aidtopia/portable_prop_power/portable_prop_power.kicad_pcb

## KiCad design Tank Panther/circuits/Circuits Du Char/Circuits Du Char.kicad_sch

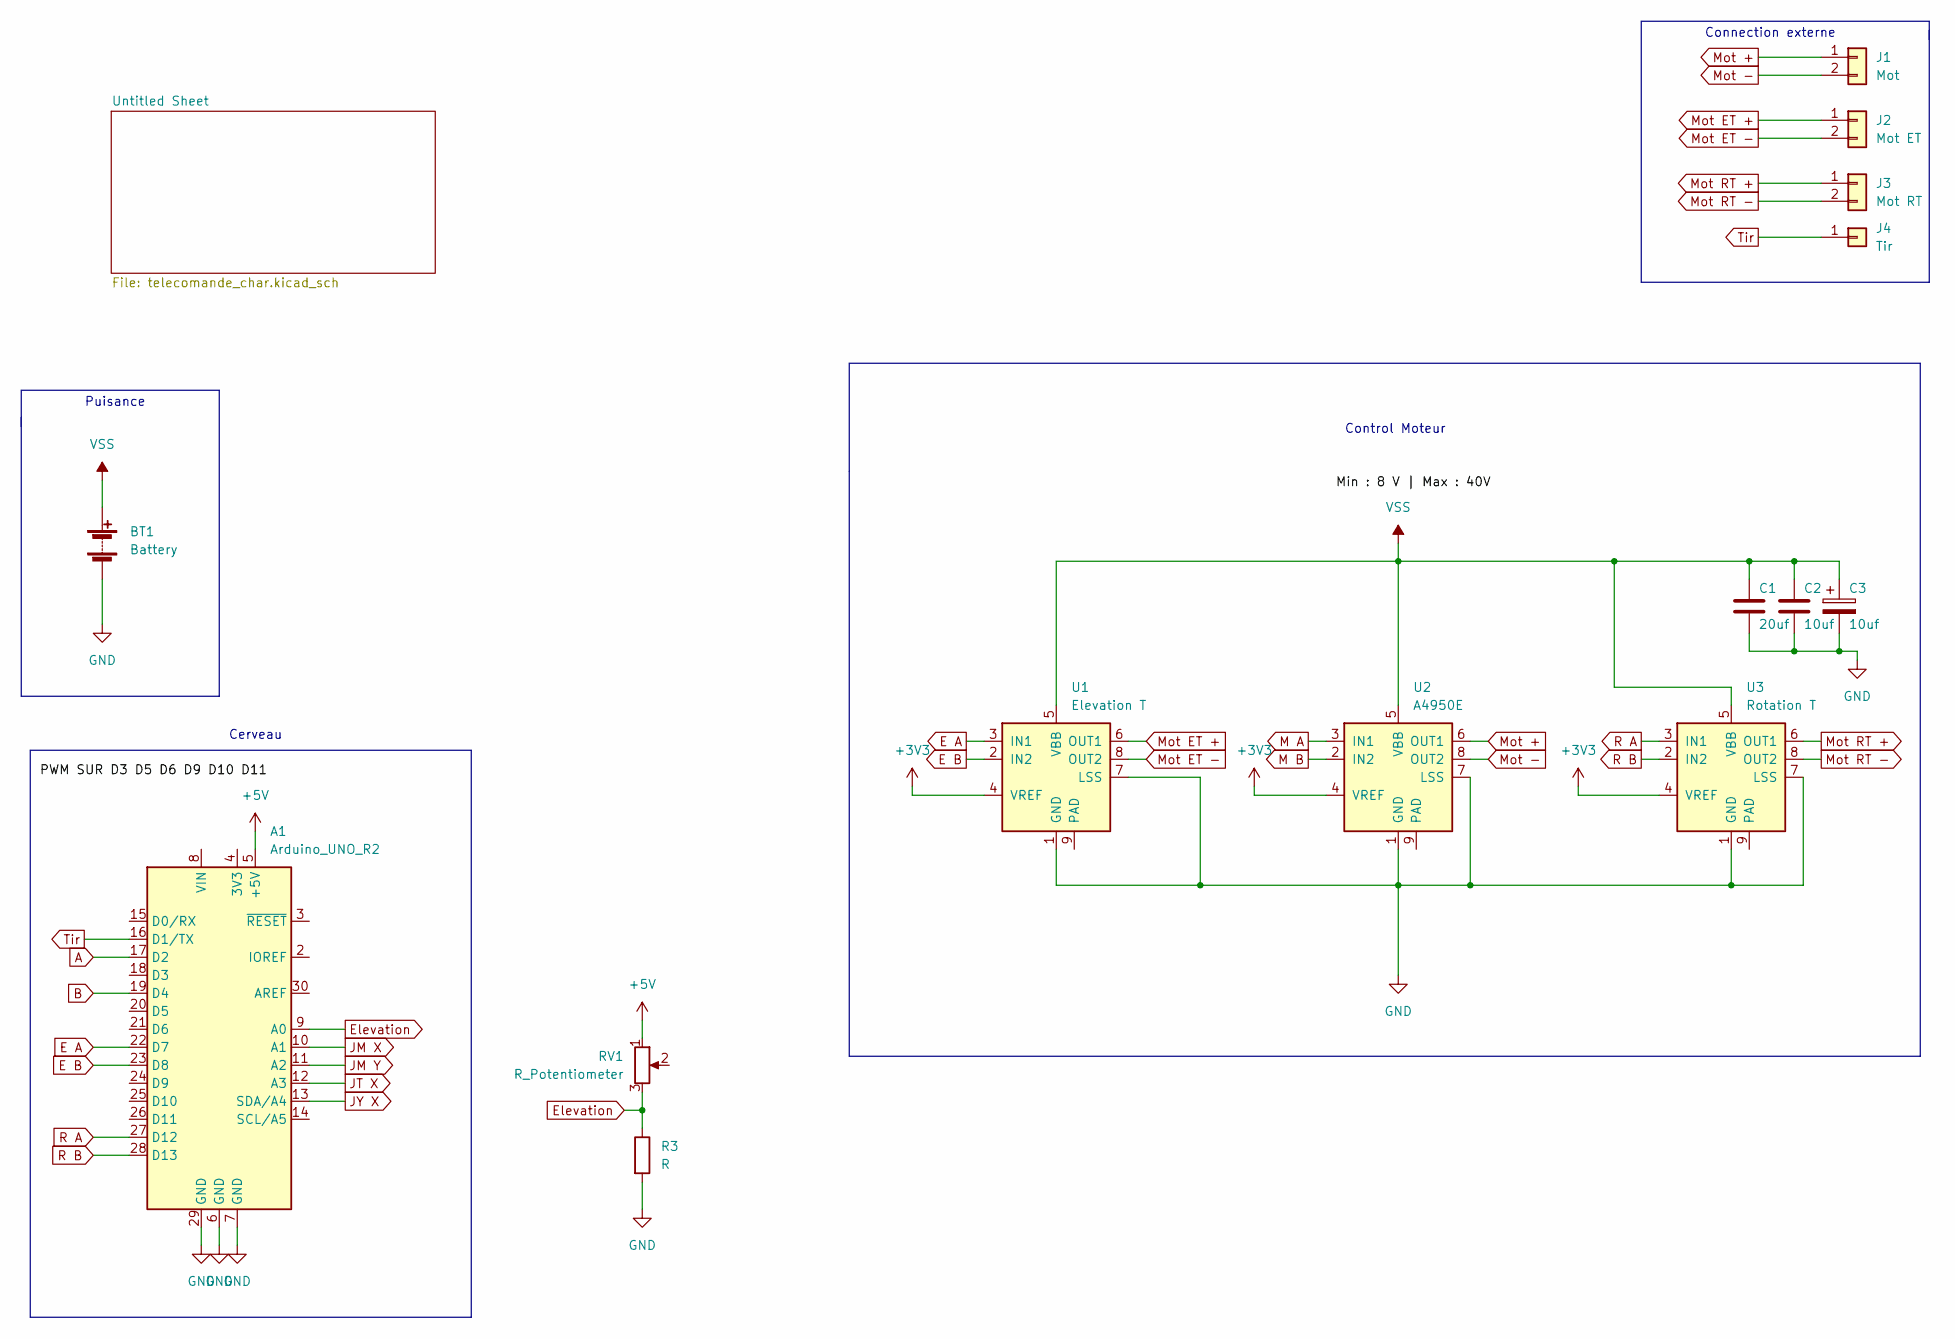
[picture p1: schematic Circuits Du Char.kicad_sch]

Parts:
A1: Arduino_UNO_R2; Arduino_UNO_R2_WithMountingHoles
BT1: Battery
C1: 20uf
C2, C3: 10uf
J1: Mot
J2: Mot ET
J3: Mot RT
J4: Tir
R3: R
RV1: R_Potentiometer
U1: Elevation T; SOIC-8-1EP_3.9x4.9mm_P1.27mm_EP2.41x3.3mm
U2: A4950E; SOIC-8-1EP_3.9x4.9mm_P1.27mm_EP2.41x3.3mm
U3: Rotation T; SOIC-8-1EP_3.9x4.9mm_P1.27mm_EP2.41x3.3mm

Connections:
+3V3: U1.4 (VREF), U2.4 (VREF), U3.4 (VREF)
+5V: A1.5 (+5V), RV1.1
A: A1.17 (D2)
B: A1.19 (D4)
E A: A1.22 (D7), U1.3 (IN1)
E B: A1.23 (D8), U1.2 (IN2)
Elevation: A1.9 (A0), R3.1, RV1.3
GND: A1.6 (GND), A1.7 (GND), A1.29 (GND), BT1.2 (-), C1.2, C2.2, C3.2, R3.2, U1.1 (GND), U1.7 (LSS), U2.1 (GND), U2.7 (LSS), U3.1 (GND), U3.7 (LSS)
JM X: A1.10 (A1)
JM Y: A1.11 (A2)
JT X: A1.12 (A3)
JY X: A1.13 (SDA/A4)
M A: U2.3 (IN1)
M B: U2.2 (IN2)
Mot +: J1.1, U2.6 (OUT1)
Mot -: J1.2, U2.8 (OUT2)
Mot ET +: J2.1, U1.6 (OUT1)
Mot ET -: J2.2, U1.8 (OUT2)
Mot RT +: J3.1, U3.6 (OUT1)
Mot RT -: J3.2, U3.8 (OUT2)
R A: A1.27 (D12), U3.3 (IN1)
R B: A1.28 (D13), U3.2 (IN2)
Tir: A1.16 (D1/TX), J4.1
VSS: BT1.1 (+), C1.1, C2.1, C3.1, U1.5 (VBB), U2.5 (VBB), U3.5 (VBB)

Notes on the sheet:
Cerveau
Connection externe
Control Moteur
Puisance
