aidtopia/portable_prop_power/portable_prop_power.kicad_pcb

## KiCad design Tank Panther/circuits/Circuits Du Char/untitled.kicad_sch

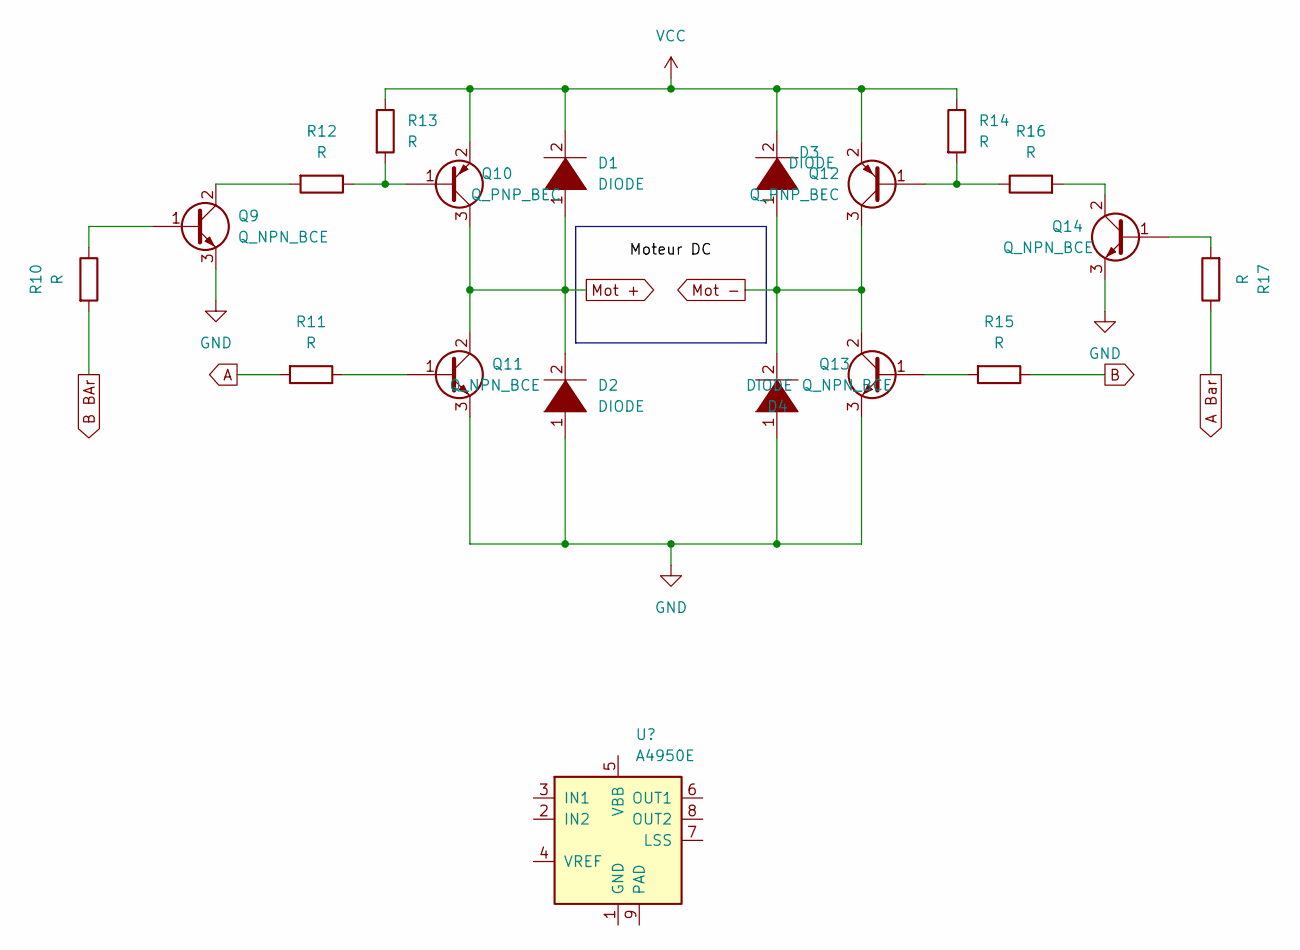
[picture p2: schematic untitled.kicad_sch]

Parts:
D1, D2, D3, D4: DIODE
Q9, Q11, Q13, Q14: Q_NPN_BCE
Q10, Q12: Q_PNP_BEC
R10, R11, R12, R13, R14, R15, R16, R17: R

Connections:
A: R11.2
A Bar: R17.1
B: R15.1
B BAr: R10.2
GND: D2.1 (K), D4.1 (K), Q9.3 (E), Q11.3 (E), Q13.3 (E), Q14.3 (E)
Mot +: D1.1 (K), D2.2 (A), Q10.3 (C), Q11.2 (C)
Mot -: D3.1 (K), D4.2 (A), Q12.3 (C), Q13.2 (C)
unnamed: Q9.1 (B), R10.1
unnamed: Q9.2 (C), R12.2
unnamed: Q10.1 (B), R12.1, R13.2
unnamed: Q11.1 (B), R11.1
unnamed: Q12.1 (B), R14.2, R16.1
unnamed: Q13.1 (B), R15.2
unnamed: Q14.1 (B), R17.2
unnamed: Q14.2 (C), R16.2
VCC: D1.2 (A), D3.2 (A), Q10.2 (E), Q12.2 (E), R13.1, R14.1
