aidtopia/portable_prop_power/(commit log)

2024-03-15 Initial wiring schematics.
    [portable_prop_power.kicad_pcb, portable_prop_power.kicad_sch]
2024-03-15 Added SCAD for the control panel.
    Not final by any means.
    [portable_prop_power_panel.scad]
2024-03-16 Added STL files to .gitignore.
2024-03-16 Iterated on the wiring diagram. Eliminated one connector.
    [portable_prop_power.kicad_sch]
2024-03-16 First attempt at defining the layout of the components in the case.
    [portable_prop_power_panel.scad]
2024-03-17 Reworked schematic again.
    * Removed the dipictions of the lever nuts.
    * Updated the symbols for the panel meters and added a note.
    * Corrected panel meter connections after reviewing seller's diagrams.
    * Adjusted layout to separate the panel-mount components from the ones
    in the box in an effort to find better ways to make all of the wiring
    connections.
    * Added a fuse.
    [portable_prop_power.kicad_sch]
2024-03-23 Continued hacking on the project box design.
    [portable_prop_power_panel.scad]
2024-03-24 Improved the project box design.
    This should be "complete enough" to make a functional power supply,
    though code could stand a bunch more refactoring, and it's all pretty
    specific about the particular modules being used.
    [portable_prop_power_panel.scad]
2024-03-25 Added labels to base plate.
    [portable_prop_power_panel.scad]
2024-03-26 Started separating the walls of the box from the base.
    [portable_prop_power_panel.scad]
2024-03-26 Renamed several variables as a refactor step.
    [portable_prop_power_panel.scad]
2024-03-26 Added explanation and modeled a hole instead of a grommet.
    [portable_prop_power_panel.scad]
2024-03-26 Refactored to eliminate a lot of duplicate parameter definitions.
    Moved the three main modules inside a module that represents the entire
    box so that key dimensions could be set in a single place.
    [portable_prop_power_panel.scad]
2024-03-26 Finally made it possible to mate the walls with the base.
    [portable_prop_power_panel.scad]
2024-03-27 Made Ridgid adapter from Anztek fit the base.
    The center pair of holes from my more recently ordered adapter plate
    are at a different offset than the ones on the Ecarke brand one I
    already had. The base now has pilot holes for both, so you can mount
    either. The unused pair of pilot holes is covered by the plate.
    [portable_prop_power_panel.scad]
2024-03-27 Tweaked the teardrop shape of the horizontal holes for the glands.
    [portable_prop_power_panel.scad]
2024-03-27 Corrected screw spacing for LM2596 (HW-411) module.
    [portable_prop_power_panel.scad]
2024-03-28 Lowered the default height for the walls in the project box.
    I wasn't really using 64 mm anyway. My current prototype is 58 mm,
    which is still a few millimeters taller than necessary.
    [portable_prop_power_panel.scad]
2024-04-02 Added wire color notations to schematic.
    I'm not sure whether that's a good color scheme, but it's something I'm
    considering to make it simpler to wire correctly.
    [portable_prop_power.kicad_sch]
2024-04-02 Adjusted some parameters for a better fit.
    * Increased pilot hole size in vertical supports of the walls, which
    were a little too tight.
    * Moved the glands up and in a small amount to create clearance for the
    levers on the nearby Wago connectors to operate.
    * Nudged the Tobsun buck toward the back wall to make a little more
    clearance near the output screw terminals.
    [portable_prop_power_panel.scad]
2024-04-02 Added keys to the walls that double as bracing for the output glands.
    [portable_prop_power_panel.scad]
